spacecraft-design-lab-2019/Solar-Panel-X/SolarCellX_v3.step

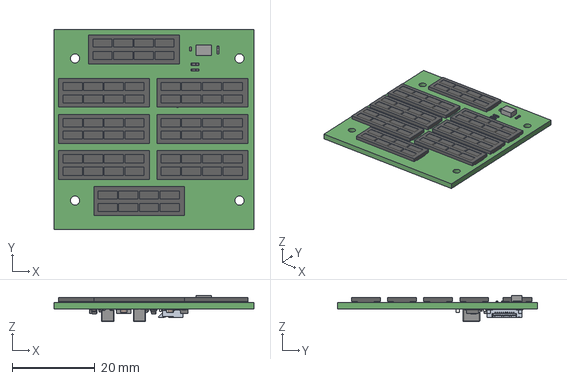
[picture p1: CAD file, 2020-03-01]
SolarCellX_v3.step
48.4 x 48.4 x 6.35 mm
