spacecraft-design-lab-2019/Solar-Panel-X/archive/v3_SolarCellX/SolarCellX_v3.step

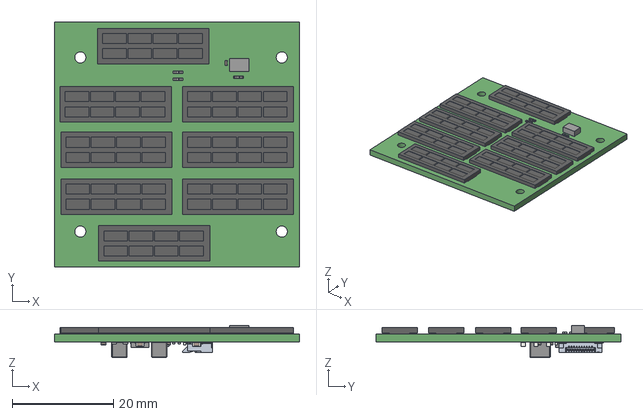
[picture p2: CAD file, 2019-10-28, an earlier design]
archive/v3_SolarCellX/SolarCellX_v3.step
48.4 x 48.4 x 6.35 mm
