spacecraft-design-lab-2019/Solar-Panel-X/SolarCellX_v3.kicad_pcb

## KiCad design SolarCellX_v3.kicad_pcb (2020-03-01)

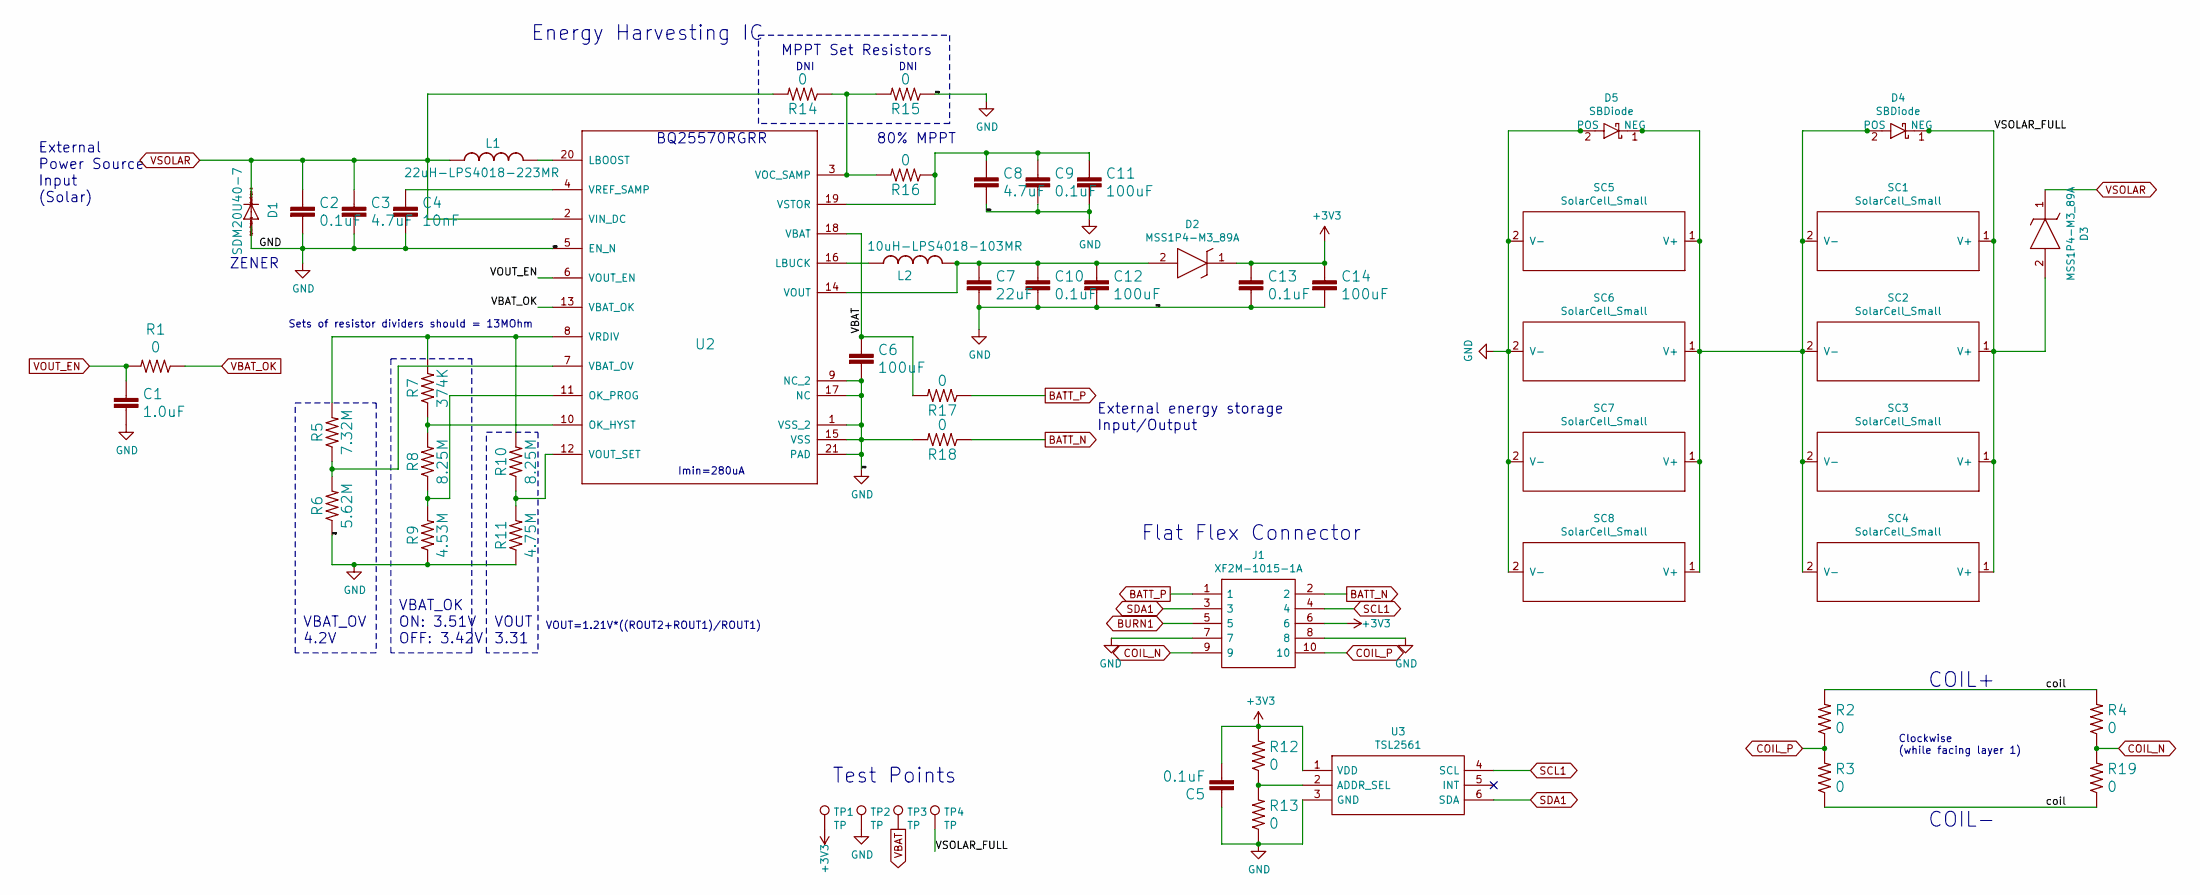
[picture p3: schematic SolarCellX_v3.sch]

Parts:
C1: 1.0uF; C_0402_1005Metric
C2, C5, C9, C10, C13: 0.1uF; C_0402_1005Metric
C3, C8: 4.7uF; C_0402_1005Metric
C4: 10nF; C_0402_1005Metric
C6, C11, C12, C14: 100uF; C_0603_1608Metric
C7: 22uF; C_0402_1005Metric
D1: SDM20U40-7; SOD523
D2, D3: MSS1P4-M3_89A; MICROSMP; Manufacturer_Part_Number MSS1P4-M3/89A; Mouser Part Number 625-MSS1P4-M3
D4, D5: SBDiode; SB Diode
J1: XF2M-1015-1A; Manufacturer_Part_Number XF2M-1015-1A; Mouser Part Number 653-XF2M-1015-1A
L1: 22uH-LPS4018-223MR; LPS4018
L2: 10uH-LPS4018-103MR; LPS4018
R1, R2, R3, R4, R12, R13, R14, R15, R16, R17, R18, R19: 0; R_0402_1005Metric
R5: 7.32M; R_0402_1005Metric
R6: 5.62M; R_0402_1005Metric
R7: 374K; R_0402_1005Metric
R8, R10: 8.25M; R_0402_1005Metric
R9: 4.53M; R_0402_1005Metric
R11: 4.75M; R_0402_1005Metric
SC1, SC2, SC3, SC4, SC5, SC6, SC7, SC8: SolarCell_Small; KXOB25-05X3F
TP1, TP2, TP3, TP4: TP; TestPoint_THTPad_D1.0mm_Drill0.5mm
U2: Value; QFN50P350X350X100-21N-D
U3: TSL2561; Manufacturer_Part_Number TSL2561; Mouser Part Number N/A

Connections:
+3V3: C5.2, C13.1, C14.1, D2.1, J1.6, R12.2, TP1.1, U3.1 (VDD)
/VSOLAR_FULL: D3.2, D4.1 (NEG), SC1.1 (V+), SC2.1 (V+), SC3.1 (V+), SC4.1 (V+), TP4.1
/coil: R2.2, R3.1, R4.2, R19.1
BATT_N: J1.2, R18.1
BATT_P: J1.1, R17.1
COIL_N: J1.9, R4.1, R19.2
COIL_P: J1.10, R2.1, R3.2
GND: C1.2, C2.2, C3.2, C4.2, C5.1, C6.2, C7.2, C8.2, C9.2, C10.2, C11.2, C12.2, C13.2, C14.2, D1.A, D5.2 (POS), J1.7, J1.8, R6.1, R9.1, R11.1, R13.1, R15.1, R18.2, SC5.2 (V-), SC6.2 (V-), SC7.2 (V-), SC8.2 (V-), TP2.1, U2.1 (VSS_2), U2.5 (EN_N), U2.9 (NC_2), U2.15 (VSS), U2.17 (NC), U2.21 (PAD), U3.3 (GND)
unnamed: C4.1, U2.4 (VREF_SAMP)
unnamed: C7.1, C10.1, C12.1, D2.2, L2.2, U2.14 (VOUT)
unnamed: C8.1, C9.1, C11.1, R16.1, U2.19 (VSTOR)
unnamed: D4.2 (POS), D5.1 (NEG), SC1.2 (V-), SC2.2 (V-), SC3.2 (V-), SC4.2 (V-), SC5.1 (V+), SC6.1 (V+), SC7.1 (V+), SC8.1 (V+)
unnamed: L1.2, U2.20 (LBOOST)
unnamed: L2.1, U2.16 (LBUCK)
unnamed: R5.1, R6.2, U2.7 (VBAT_OV)
unnamed: R7.1, R8.2, U2.10 (OK_HYST)
unnamed: R8.1, R9.2, U2.11 (OK_PROG)
unnamed: R10.1, R11.2, U2.12 (VOUT_SET)
unnamed: R5.2, R7.2, R10.2, U2.8 (VRDIV)
unnamed: R12.1, R13.2, U3.2 (ADDR_SEL)
unnamed: R14.1, R15.2, R16.2, U2.3 (VOC_SAMP)
SCL1: J1.4, U3.4 (SCL)
SDA1: J1.3, U3.6 (SDA)
VBAT: C6.1, R17.2, TP3.1, U2.18 (VBAT)
VBAT_OK: R1.1, U2.13 (VBAT_OK)
VOUT_EN: C1.1, R1.2, U2.6 (VOUT_EN)
VSOLAR: C2.1, C3.1, D1.C, D3.1, L1.1, R14.2, U2.2 (VIN_DC)

Notes on the sheet:
DNI
ZENER
VOUT 3.31
80% MPPT
VBAT_OK ON: 3.51V OFF: 3.42V
Imin=280uA
External Power Source Input (Solar)
External energy storage Input/Output
BQ25570RGRR
Energy Harvesting IC
VBAT_OV 4.2V
Sets of resistor dividers should = 13MOhm
VOUT=1.21V*((ROUT2+ROUT1)/ROUT1)
MPPT Set Resistors
Flat Flex Connector
COIL+
COIL-
Clockwise (while facing layer 1)
Test Points

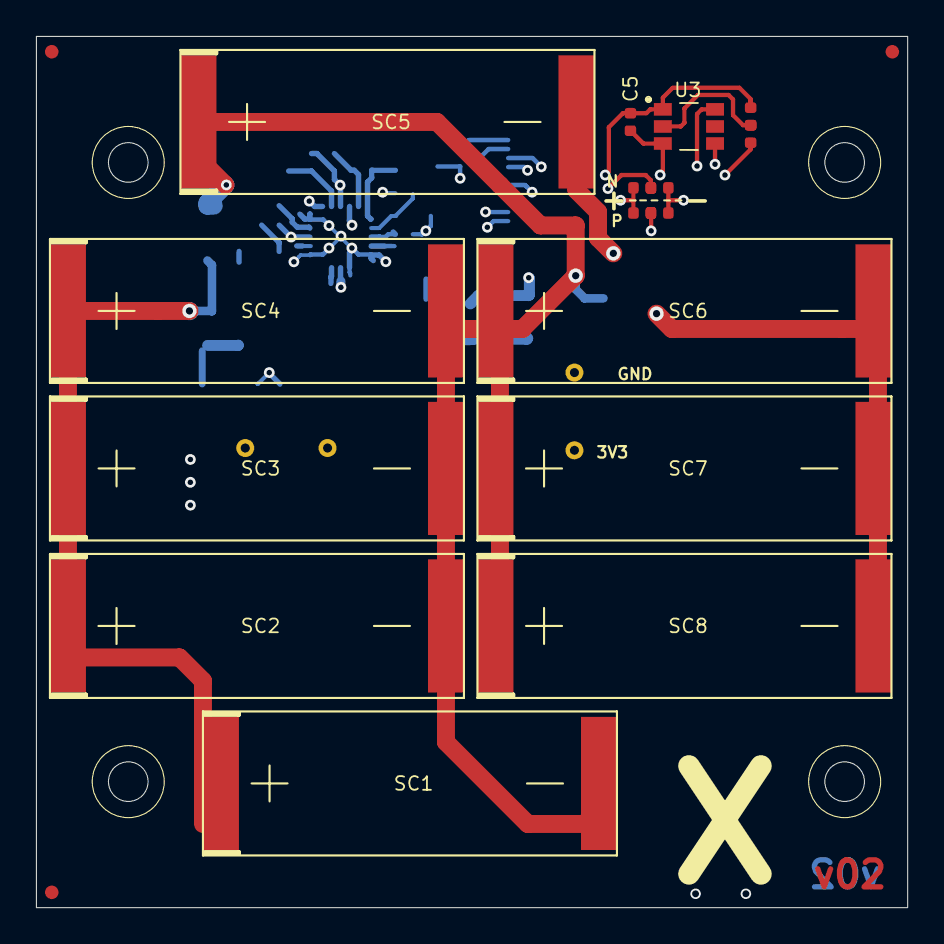
[picture p4: board SolarCellX_v3.kicad_pcb from above]

Board: 6 copper layers, 48.4 x 48.4 mm, 55 parts (0 on the bottom side), 27 nets.
