spacecraft-design-lab-2019/Solar-Panel-X/(commit log)

2019-10-21 SolarCellX_v1 initial upload
    This is just to add the footprints and libraries for the solar cells and diodes to the Git - the board layout is not finished!
    [SolarCellX_v1.kicad_pcb, SolarCellX_v1.sch]
2019-10-21 Finished the trace layout
    [SolarCellX_v1.kicad_pcb]
2019-10-23 Added the mounting & USB hole
    [SolarCellX_v1.kicad_pcb]
2019-10-23 Updated Board Cuts and Solar Cell choice
    The traces & Magnetorquers haven't been put in yet - still finalizing hole layout with structures
    [SolarCell+X_v2.kicad_pcb, SolarCell+X_v2.sch, SolarCell-X_v2.kicad_pcb, SolarCell-X_v2.sch]
2019-10-24 Added the first layer of the magnetorquer
    [SolarCell+X_v2.kicad_pcb, SolarCellX_v1.kicad_pcb, SolarCellX_v1.sch, SolarCellX_v3.kicad_pcb, SolarCellX_v3.sch]
2019-10-24 Finished the Magnetorquer
    [SolarCellX_v3.kicad_pcb]
2019-10-25 Cleaned up the Magnetorquer and added labels
    [SolarCellX_v3.kicad_pcb, SolarCellX_v3.sch]
2019-10-25 making libraries locally referenced for easy import
    [SolarCellX_v3.kicad_pcb, SolarCellX_v3.sch, file5DB3365B.sch]
2019-10-25 preparing to import misc-circuits
    [SolarCellX_v3.kicad_pcb]
2019-10-25 circuits added and coil connection made
    [SolarCellX_v3.kicad_pcb, SolarCellX_v3.sch, SolarCellX_v3b.sch, file5DB3365B.sch]
2019-10-25 cleanup- still need to add logo
    [SolarCellX_v3.kicad_pcb]
2019-10-25 X and Z panels are ready
    [SolarCellX_v3.kicad_pcb]
2019-10-26 zipped fabrication files for all but +Y
    [SolarCellX_v3-B_Mask.gbs, SolarCellX_v3-B_Paste.gbp, SolarCellX_v3-B_SilkS.gbo, SolarCellX_v3-Bottom.gbl, SolarCellX_v3-Edge_Cuts.gm1, SolarCellX_v3-F_Mask.gts, SolarCellX_v3-F_Paste.gtp, SolarCellX_v3-F_SilkS.gto]
2019-10-26 JLCPCB fab output
    [SolarCellX_v3-B_Mask.gbr, SolarCellX_v3-B_Paste.gbr, SolarCellX_v3-B_SilkS.gbr, SolarCellX_v3-Bottom.gbr, SolarCellX_v3-Edge_Cuts.gbr, SolarCellX_v3-F_Mask.gbr, SolarCellX_v3-F_Paste.gbr, SolarCellX_v3-F_SilkS.gbr]
2019-10-28 generating 3D CAD
    [SolarCellX_v3.kicad_pcb, SolarCellX_v3.step]
2019-10-28 Added first revision of step for board - missing one connector.
2019-11-01 y+ BOM
2019-12-20 v01 order + repo overhaul
    [SolarCell+X_v2.kicad_pcb, SolarCell+X_v2.sch, SolarCell-X_v2.kicad_pcb, SolarCell-X_v2.sch, SolarCellX_v1.kicad_pcb, SolarCellX_v1.sch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]
2020-02-10 fixed pcb - schematic inconsistencies
    [SolarCellX_v3.kicad_pcb, SolarCellX_v3.sch, SolarCellX_v3.step]
2020-02-19 moved solar panel and sun sensor. Fixed PCB design rules
    [SolarCellX_v3.kicad_pcb, SolarCellX_v3.sch]
2020-02-20 updated 3d footprint paths and generated new step file
    [SolarCellX_v3.kicad_pcb, SolarCellX_v3.step]
2020-02-23 moved diode to fix mechanical collision
    [SolarCellX_v3.kicad_pcb, SolarCellX_v3.step]
2020-02-28 Changed magnetorquer coils
    [SolarCellX_v3 3.kicad_pcb]
2020-02-29 design review and generated gerbers
    [SolarCellX_v3 3.kicad_pcb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]
2020-03-01 added fiducials, regenerated 3d model and gerbers
    [SolarCellX_v3-B.Mask.gbr, SolarCellX_v3-B.Paste.gbr, SolarCellX_v3-B.SilkS.gbr, SolarCellX_v3-Bottom.gbr, SolarCellX_v3-Edge.Cuts.gbr, SolarCellX_v3-F.Mask.gbr, SolarCellX_v3-F.Paste.gbr, SolarCellX_v3-F.SilkS.gbr]
